WiseLabCMU/LPRAN/hw/LPRAN.pdf

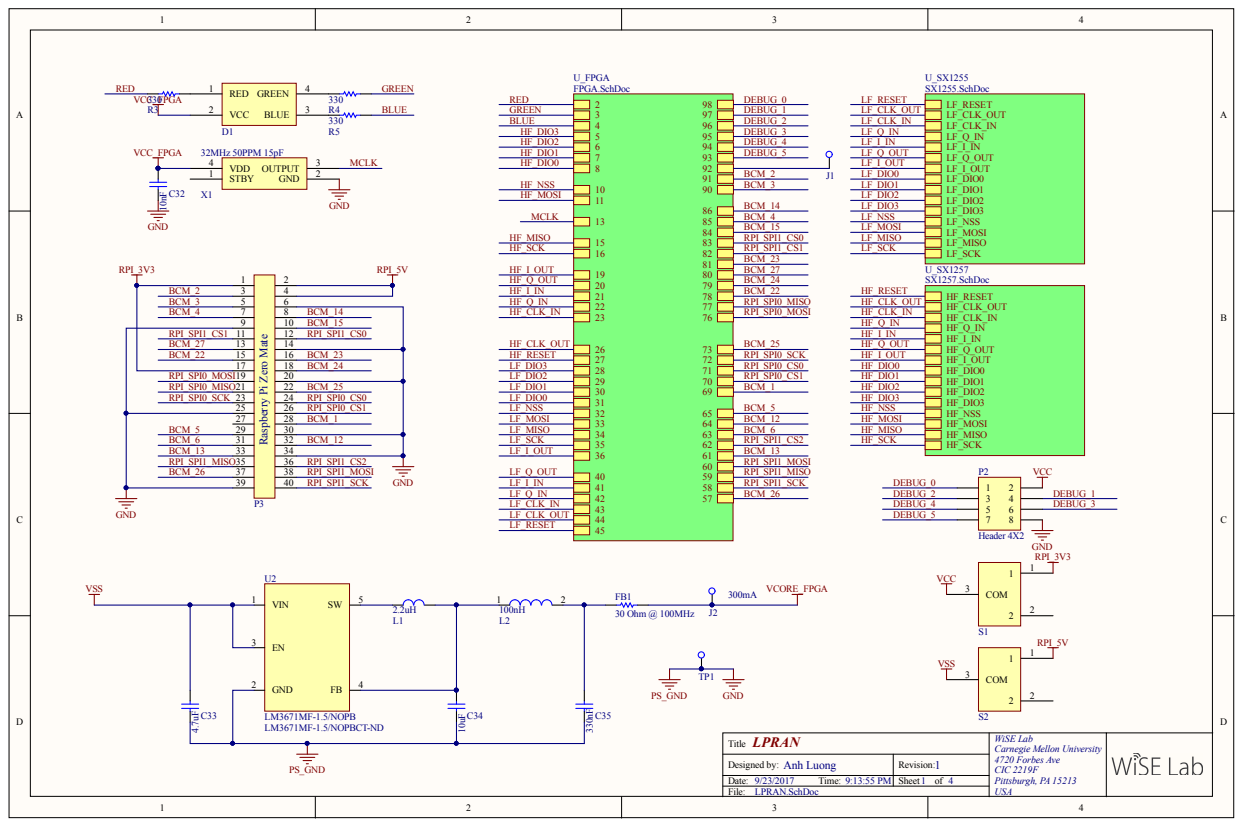
[picture p1: page 1]

LPRA | WiSE Lab Carnegie Mellon Univ ersity 4720 Forbes A v e CIC 2219F Pittsburgh, PA 15213 USA
Title Designed by: Date: File: o n g | R evision: 1

9/23/2017 Time : 9:13:55 P M | She e t 1 of 4

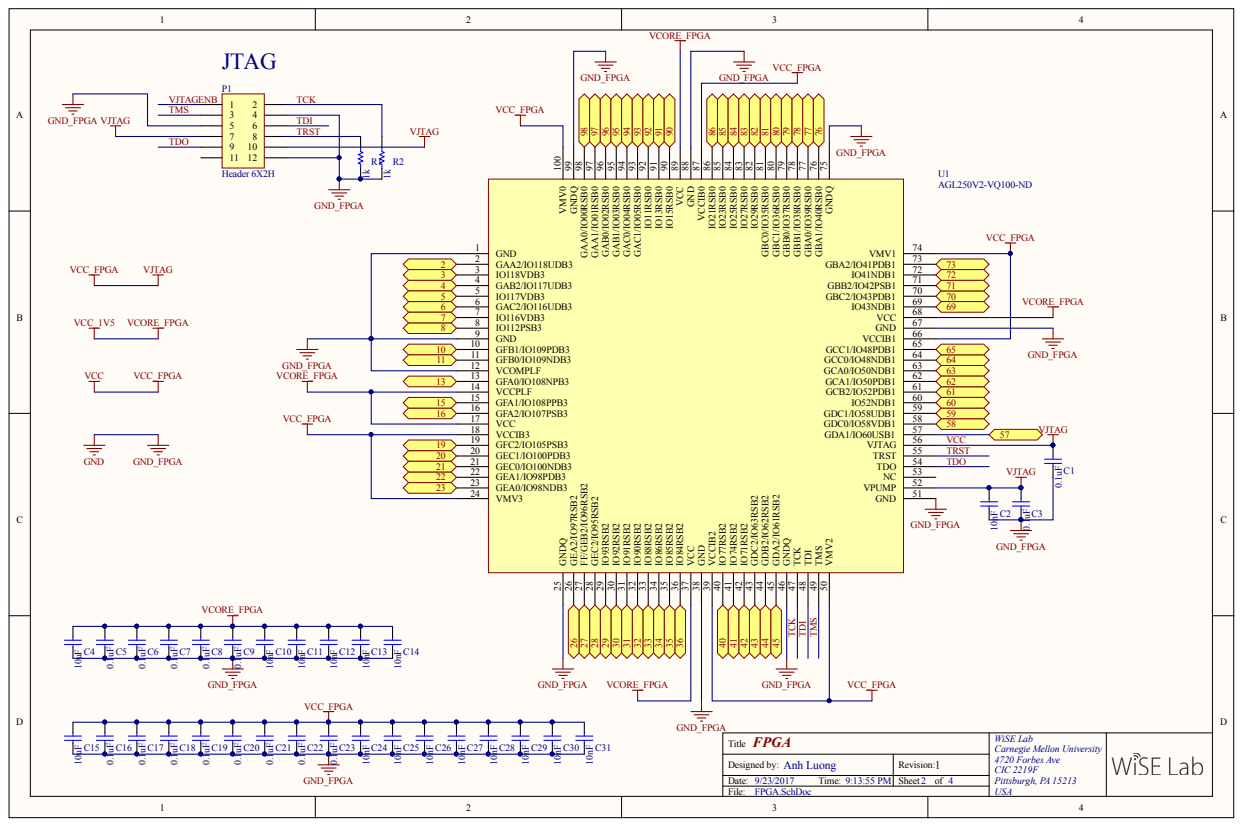
[picture p2: page 2]

GNDQ 75 GBA1/IO40RSB0 76 GBA0/IO39RSB0 77 GBB1/IO38RSB0 78 GBB0/IO37RSB0 79 GBC1/IO36RSB0 80 GBC0/IO35RSB0 81 IO29RSB0 82 IO27RSB0 83 IO25RSB0 84 IO23RSB0 85 IO21RSB0 86 VCCIB0 87 GND 88 VCC 89 IO15RSB0 90 IO13RSB0 91 IO11RSB0 92 GAC1/IO05RSB0 93 GAC0/IO04RSB0 94 GAB1/IO03RSB0 95 GAB0/IO02RSB0 96 GAA1/IO01RSB0 97 GAA0/IO00RSB0 98 GNDQ 99 VMV0 100

19 20 21 22 23 | | GFC2/IO105PSB3 19 | VCC

GEC1/IO100PDB3 20 | TRST
GEC0/IO100NDB3 21 | TDO

FPGA Title | WiSE Lab Carnegie Mellon University 4720 Forbes Ave CIC 2219F Pittsburgh, PA 15213 USA

Designed by: Anh Luong | Revision: 1
Date: 9/23/2017 Time: 9:13:55 PM | Sheet 2 of 4

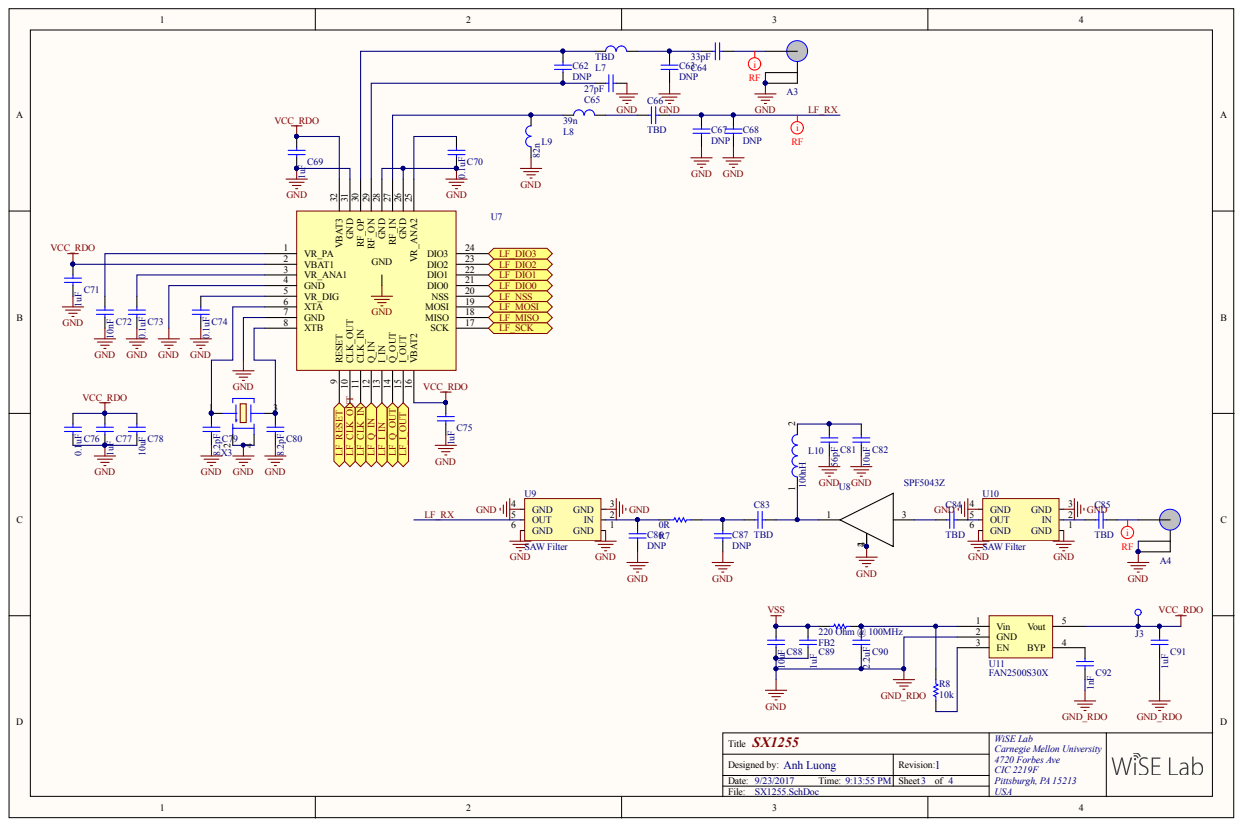
[picture p3: page 3]

GND

VBAT1 2
VR_ANA1 3
GND 4
VR_DIG 5
XTA 6
GND 7
XTB 8

GND GND

VCC_RDO

SX1255 Title | WiSE Lab Carnegie Mellon University 4720 Forbes Ave CIC 2219F Pittsburgh, PA 15213 USA

Designed by: Anh Luong | Revision: 1
Date: 9/23/2017 Time: 9:13:55 PM | Sheet 3 of 4

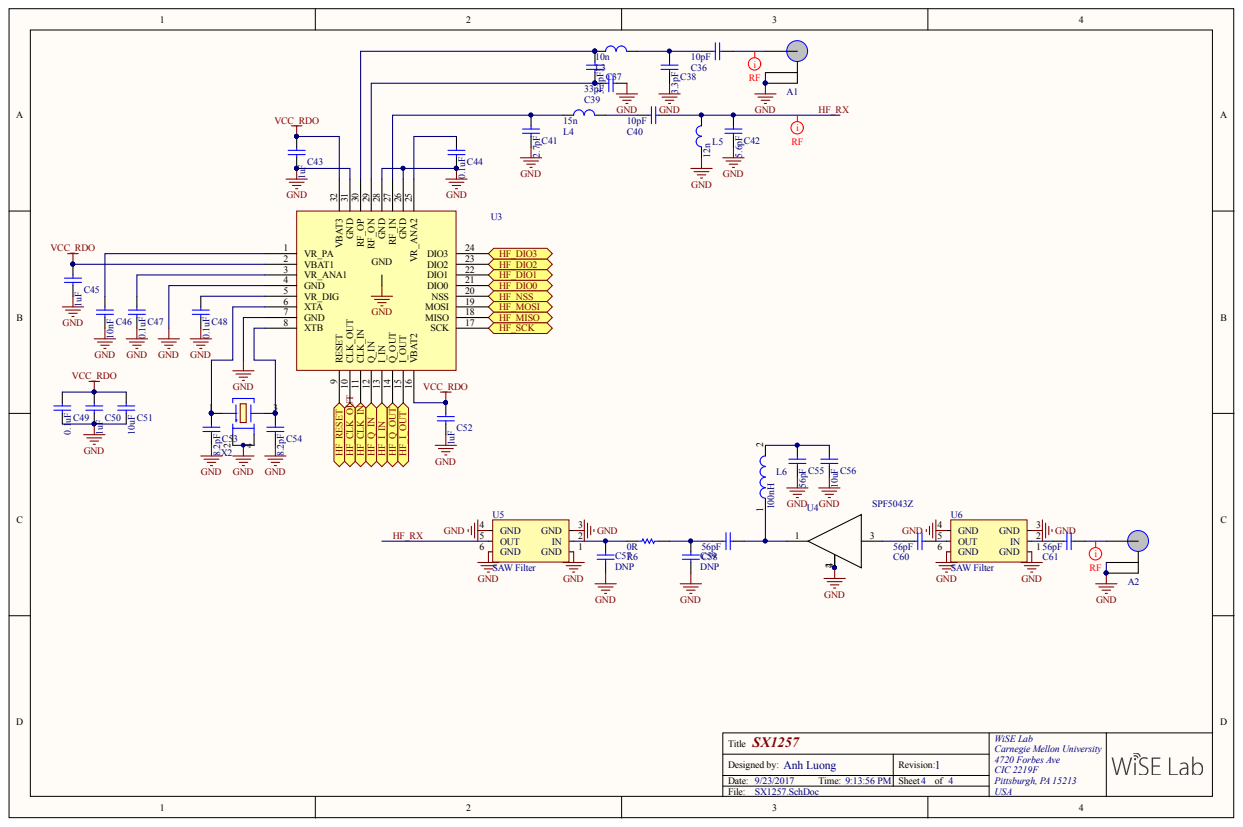
[picture p4: page 4]

GND

VBAT1 2
VR_ANA1 3
GND 4
VR_DIG 5
XTA 6
GND 7
XTB 8

GND GND

VCC_RDO

SX1257 Title | WiSE Lab Carnegie Mellon University 4720 Forbes Ave CIC 2219F Pittsburgh, PA 15213 USA

Designed by: Anh Luong | Revision: 1
Date: 9/23/2017 Time: 9:13:56 PM | Sheet 4 of 4

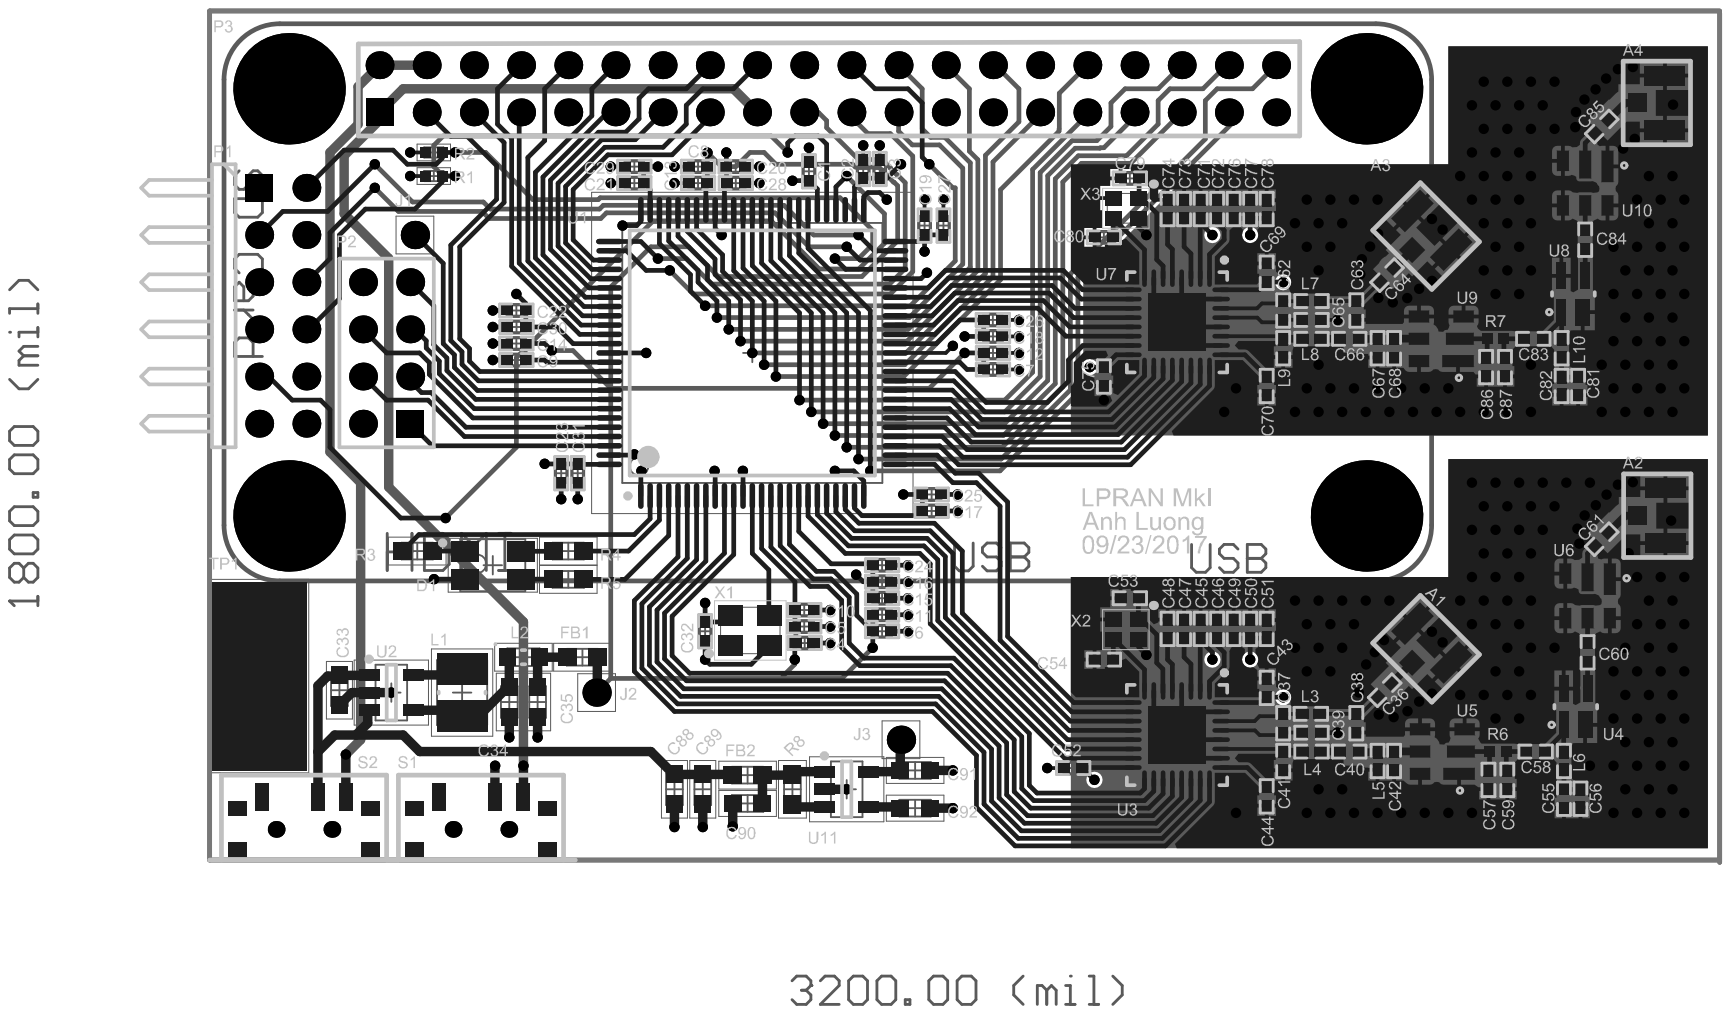
[picture p5: page 5]

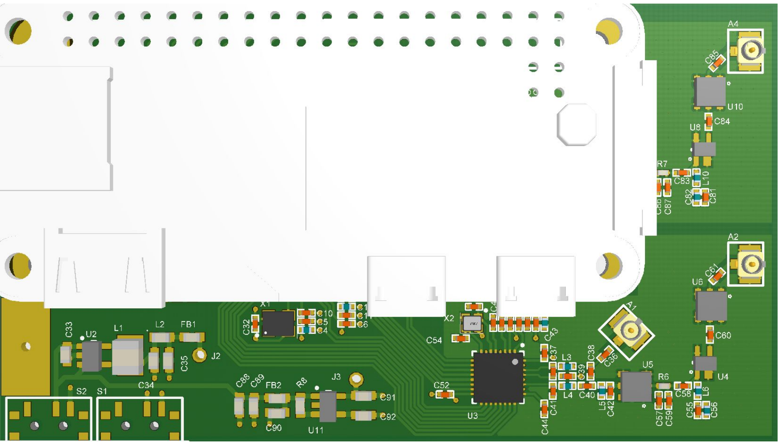
[picture p6: page 6]
