WiseLabCMU/LPRAN/(list of files, drawings)

Other design files:
hw/FPGA.SchDoc
hw/LPRAN.PcbDoc
hw/LPRAN.PrjPcb
hw/LPRAN.SchDoc
hw/SX1255.SchDoc
hw/SX1257.SchDoc
