WiseLabCMU/LPRAN/(commit log)

2017-09-27 just in case my mac dies... again
    [Bill of Materials-LPRAN.xls, FPGA.SchDoc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]
2017-10-31 double buffering functional fpga code
    [Bill of Materials-LPRAN.xls]
